bribri96/robot/README.md

# Repo che contiene il mio progetto di maturità
