bribri96/robot/Presentazione.pptx

Simulazione di un impianto industriale per la manipolazione degli oggetti
Bertolani Andrea, ITIS “E. Fermi” Modena
A.S. 2014-2015

## Slide 2

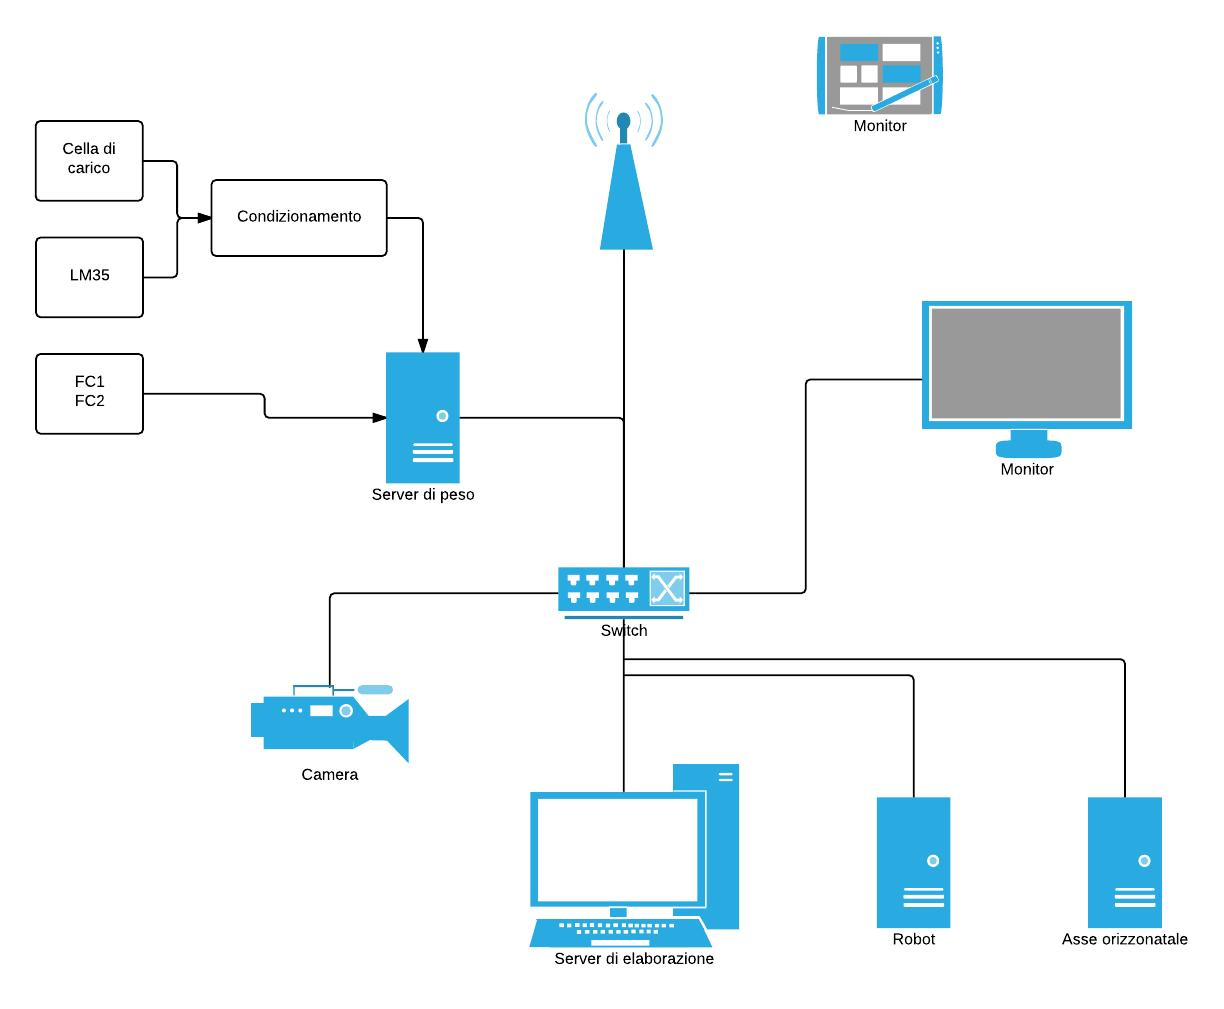
[picture p1: figure]

## Slide 3

Riconoscimento Oggetti

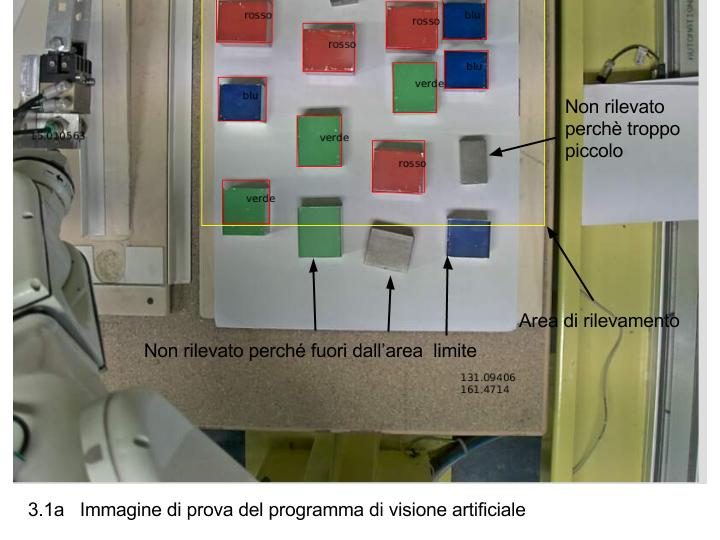
[picture p2: figure]

Parametri

Trasformazione

Trasmissione

## Slide 4

Sistema di Pesatura

- Microcontrollore
  - ADC
  - Ethernet
- Condizionamento
- Trasmissione

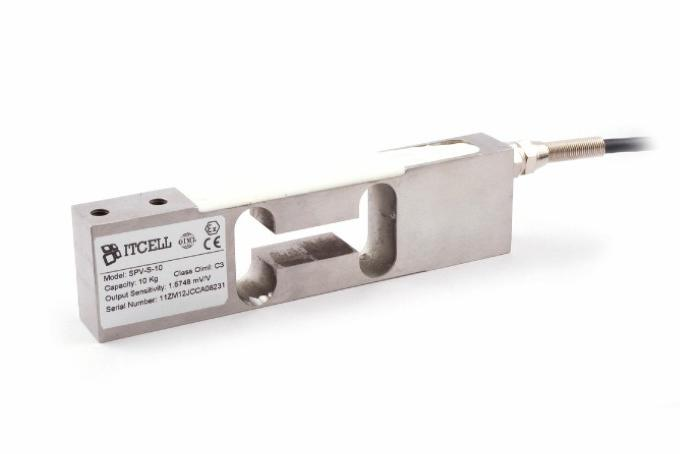
[picture p3: figure]

## Slide 5

Spostamento Oggetti

- Robot
- Ricezione dati
- Ciclo di lavoro

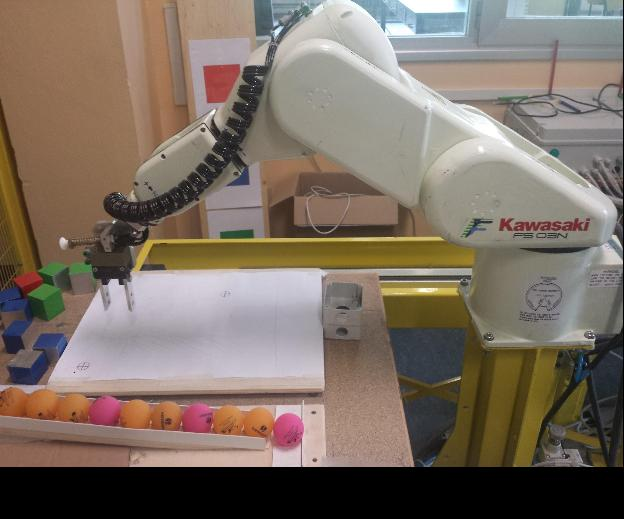
[picture p4: figure]

## Slide 6

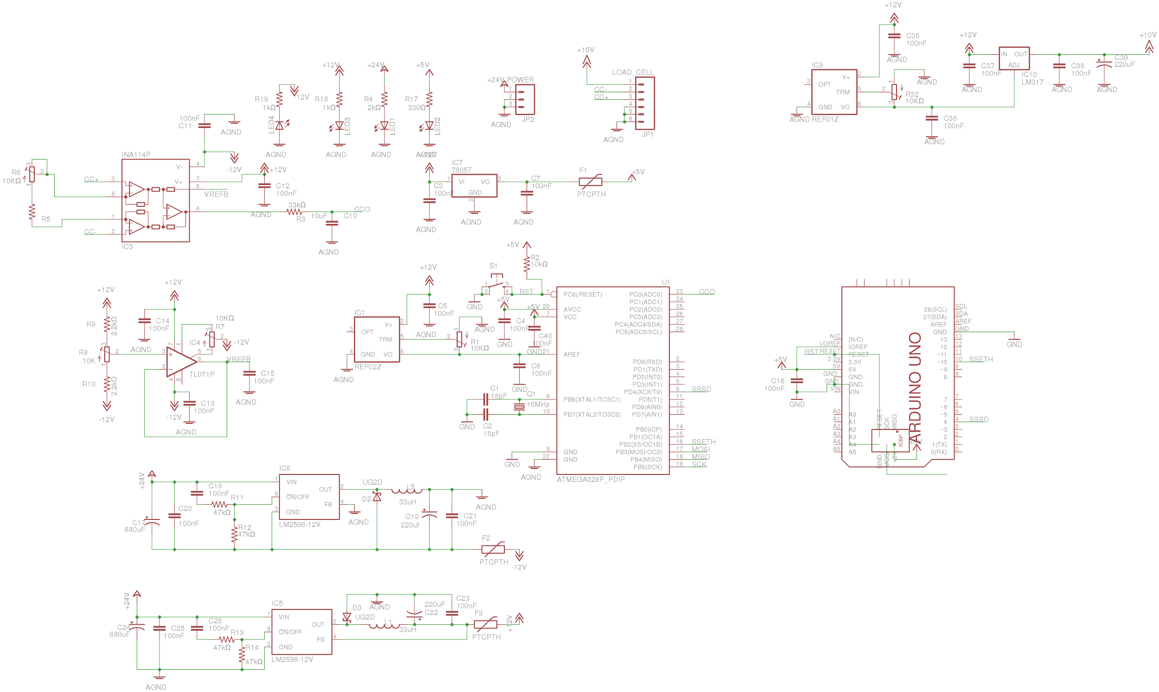
[picture p5: figure]

Schema Elettrico della Cella di Carico

## Slide 7

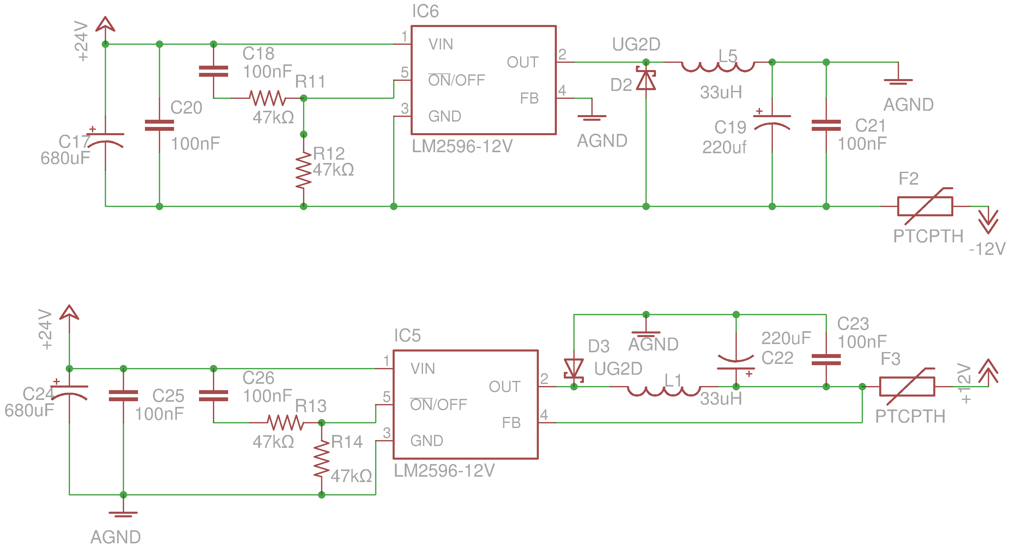
[picture p6: figure]

Power supply circuits

## Slide 8

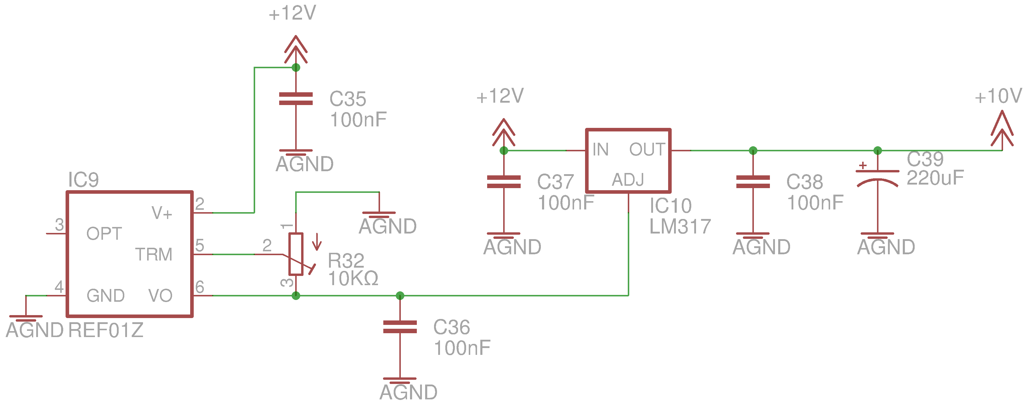
[picture p7: figure]

Load cell power supply

## Slide 9

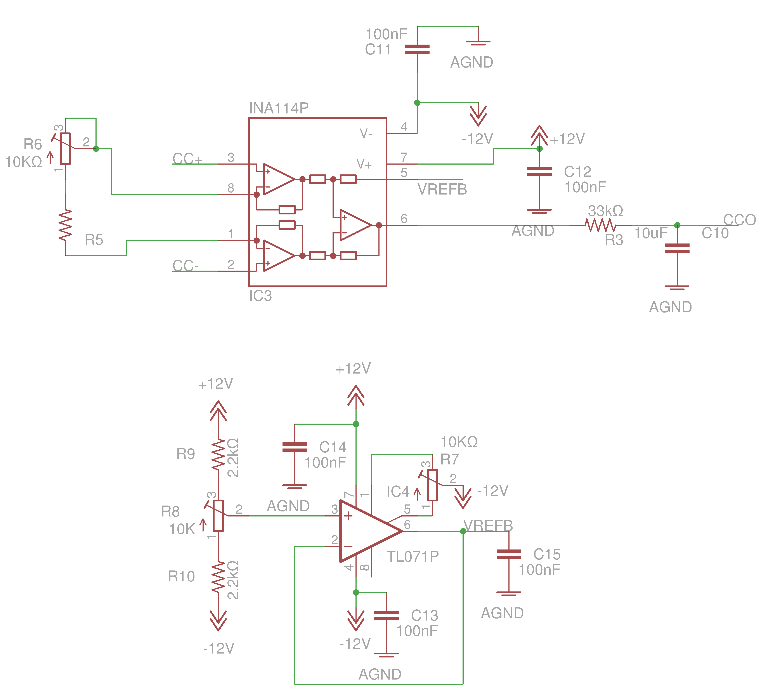
[picture p8: figure]

Amplificazione del Segnale

## Slide 10

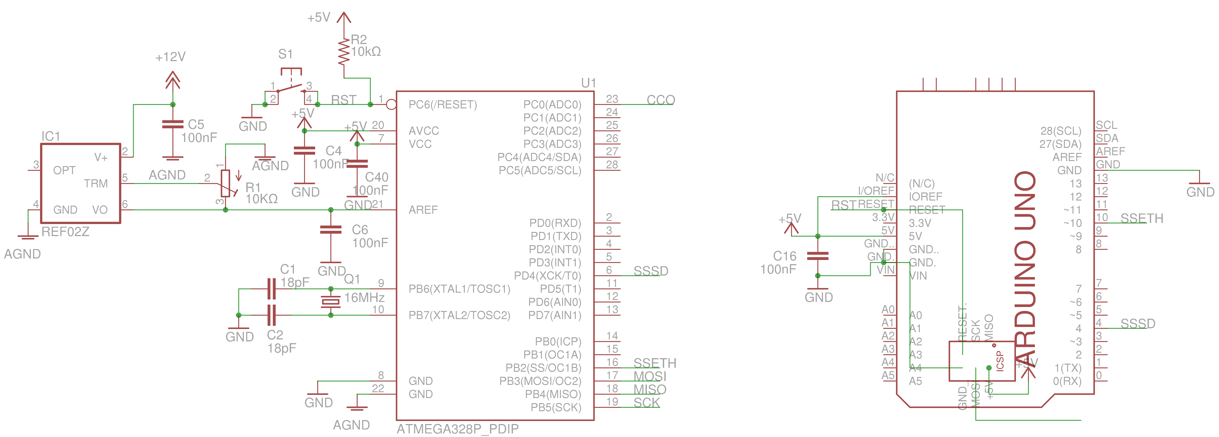
[picture p9: figure]

Microcontrollore e Scheda di Rete

## Slide 11

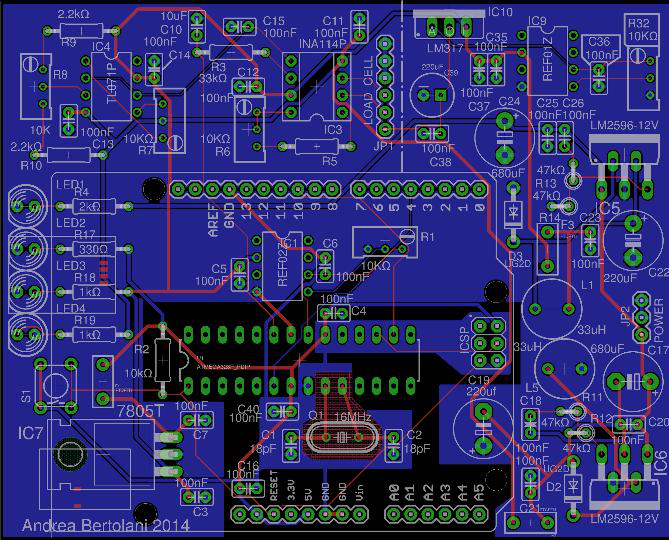
[picture p10: figure]

Circuito stampato della cella di carico

## Slide 12

## Slide 13

Grazie per l’attenzione
