bribri96/robot/schemi/delay.png

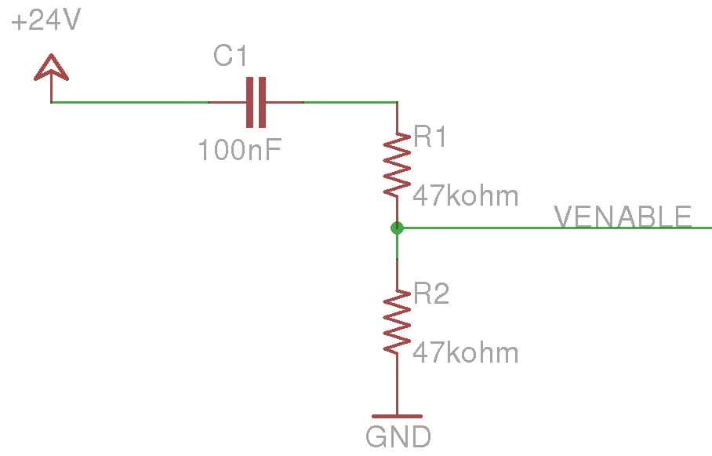
schemi/delay.png
