bribri96/robot/schemi/bilancia_smart.pdf

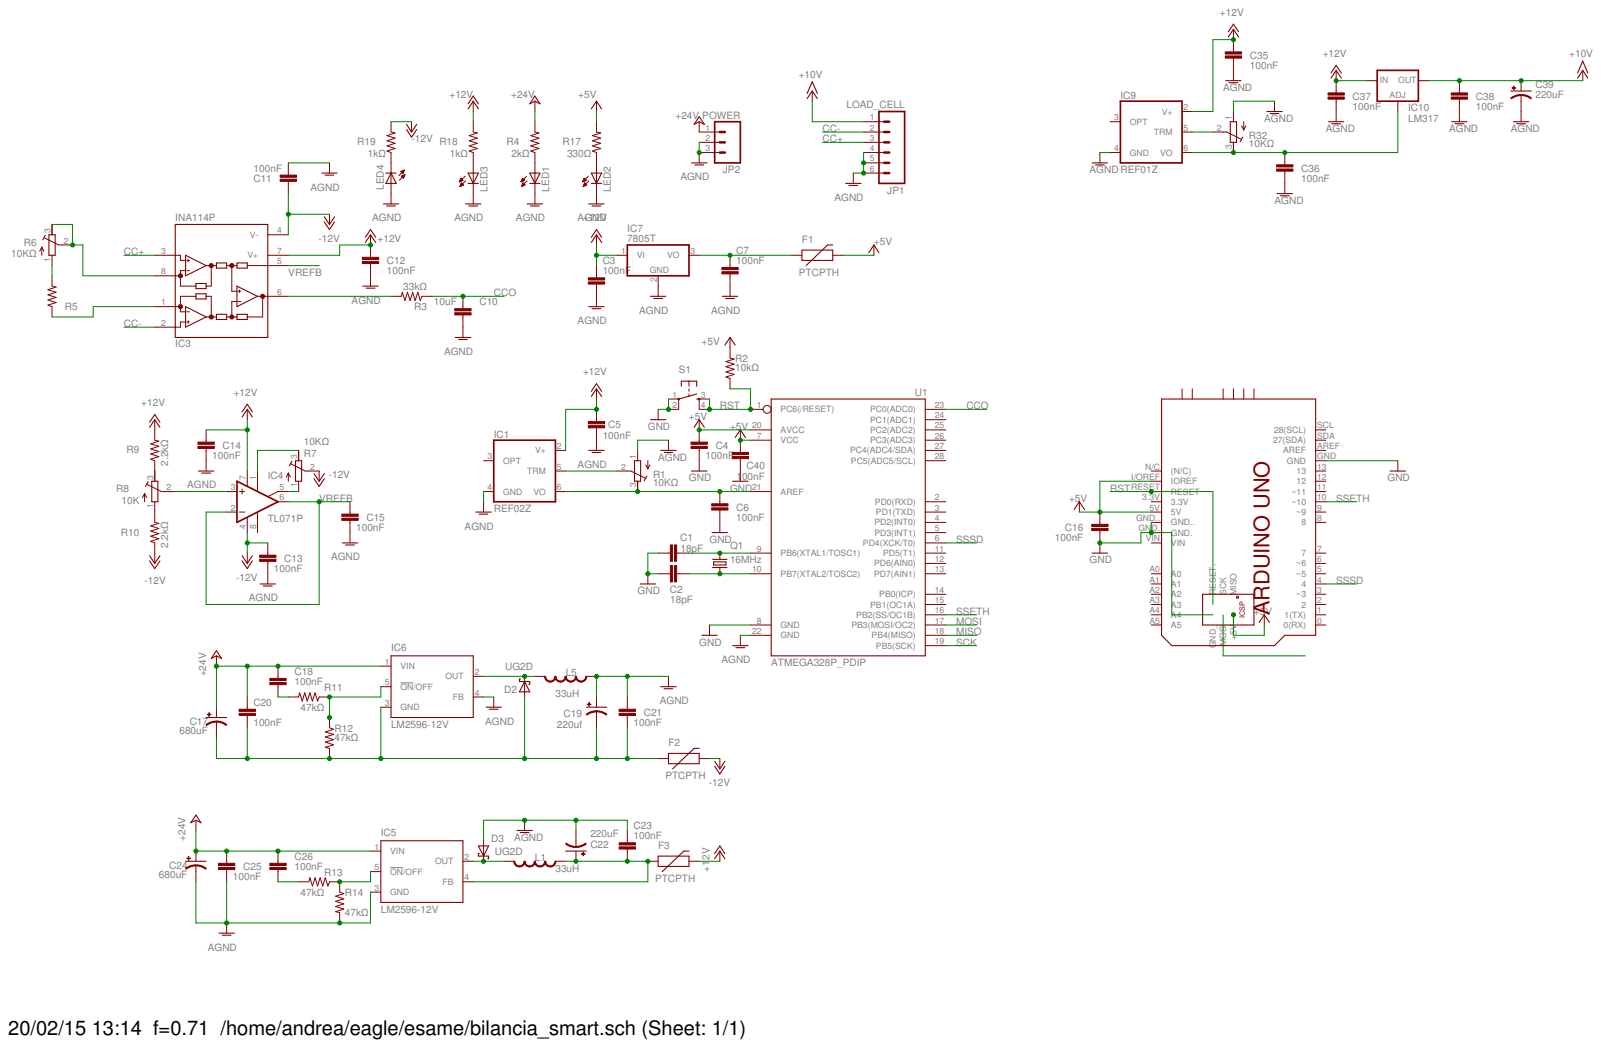
[picture p22: page 1]

+5V MOSI GND_ RESET. SCK MISO

SCK MISO MOSI SSETH

20/02/15 13:14 f=0.71 /home/andrea/eagle/esame/bilancia_smart.sch (Sheet: 1/1)
