bribri96/robot/schemi/cella_carico_sch.pdf

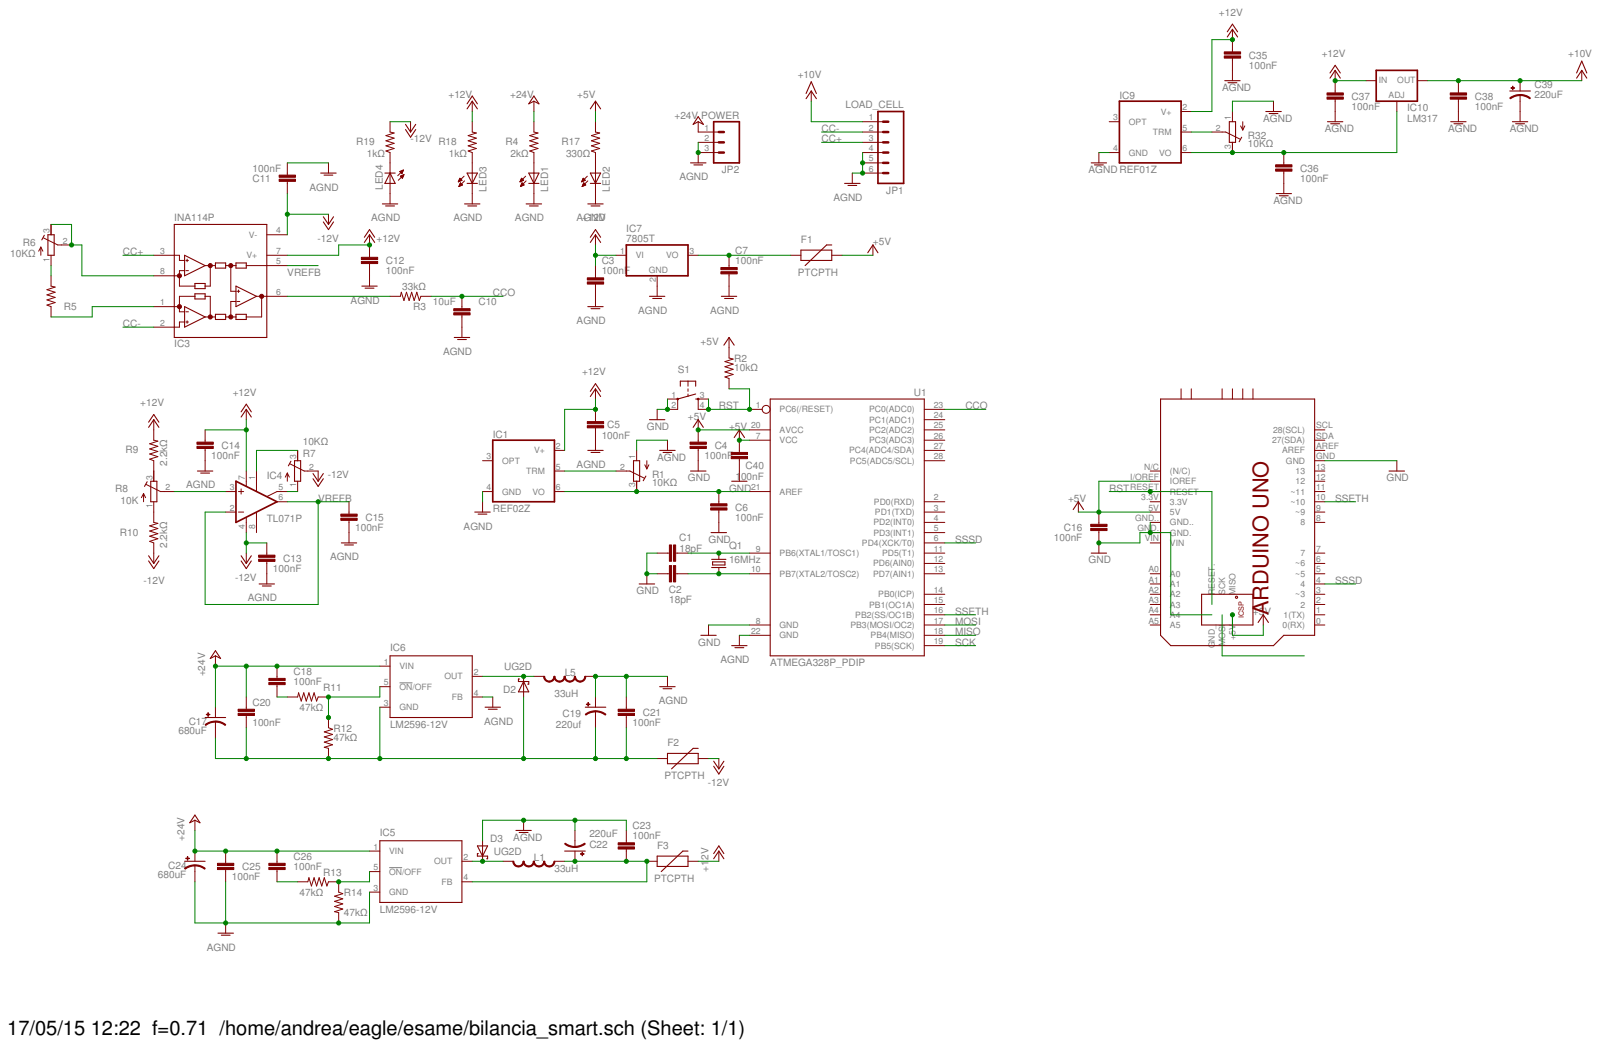
[picture p23: page 1]

+5V MOSI GND_ RESET. SCK MISO

SCK MISO MOSI SSETH

17/05/15 12:22 f=0.71 /home/andrea/eagle/esame/bilancia_smart.sch (Sheet: 1/1)
