bribri96/robot/schemi/bilancia_smart_brd.pdf

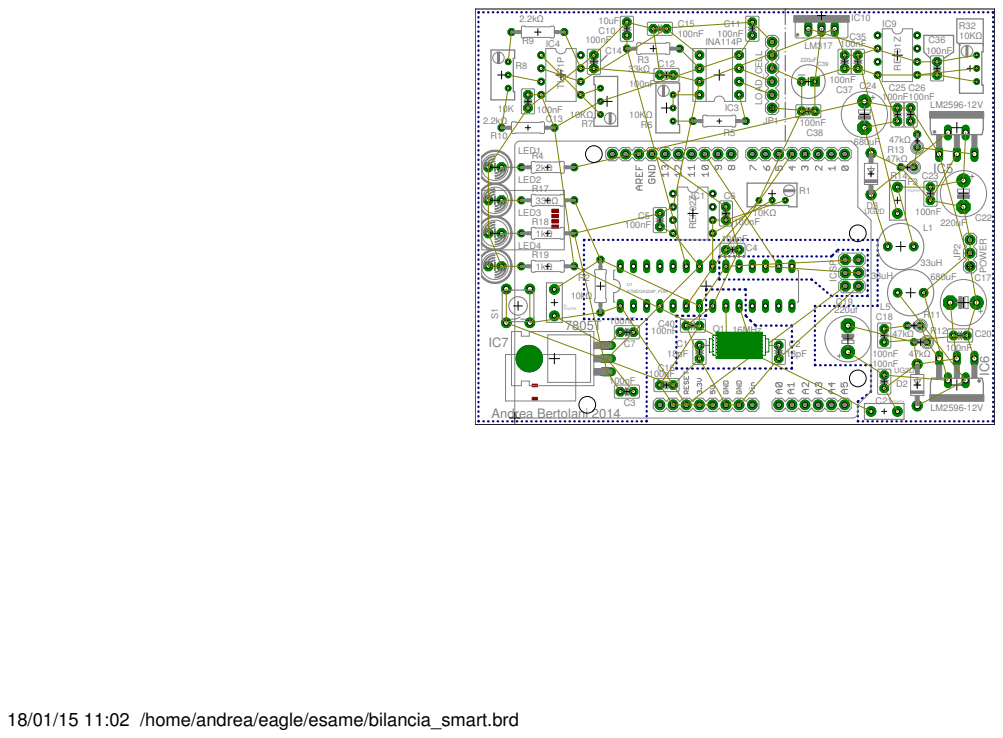
[picture p24: page 1]

18/01/15 11:02 /home/andrea/eagle/esame/bilancia_smart.brd
