bribri96/robot/schemi/cella_carico.pdf

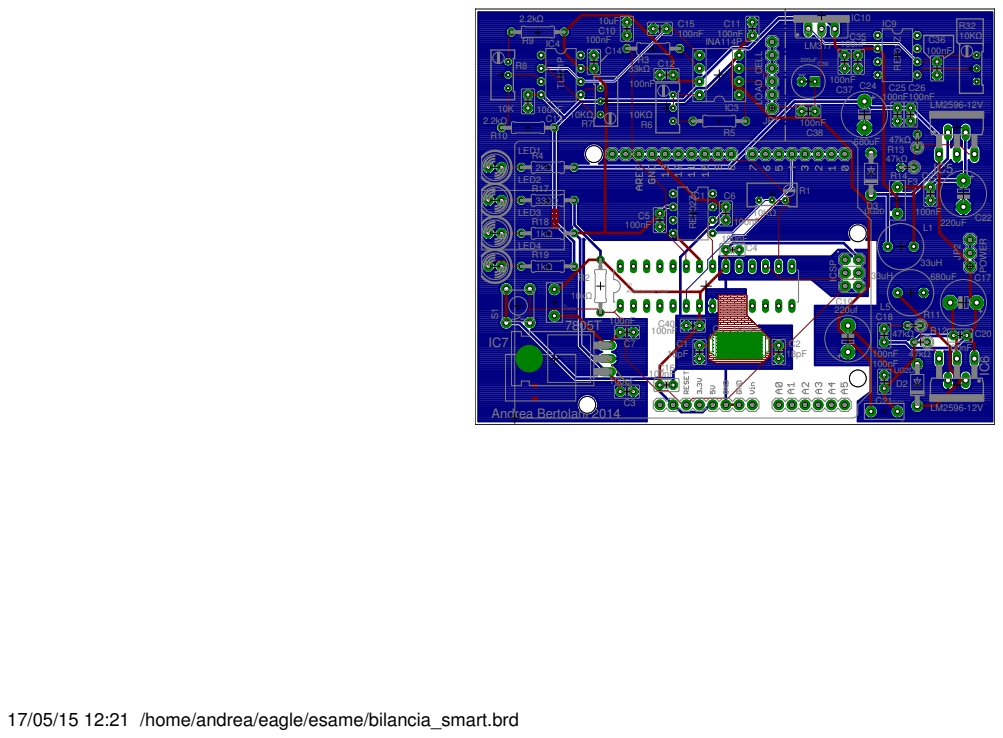
[picture p25: page 1]

17/05/15 12:21 /home/andrea/eagle/esame/bilancia_smart.brd
