bribri96/robot/schemi/cella_carico_brd.pdf

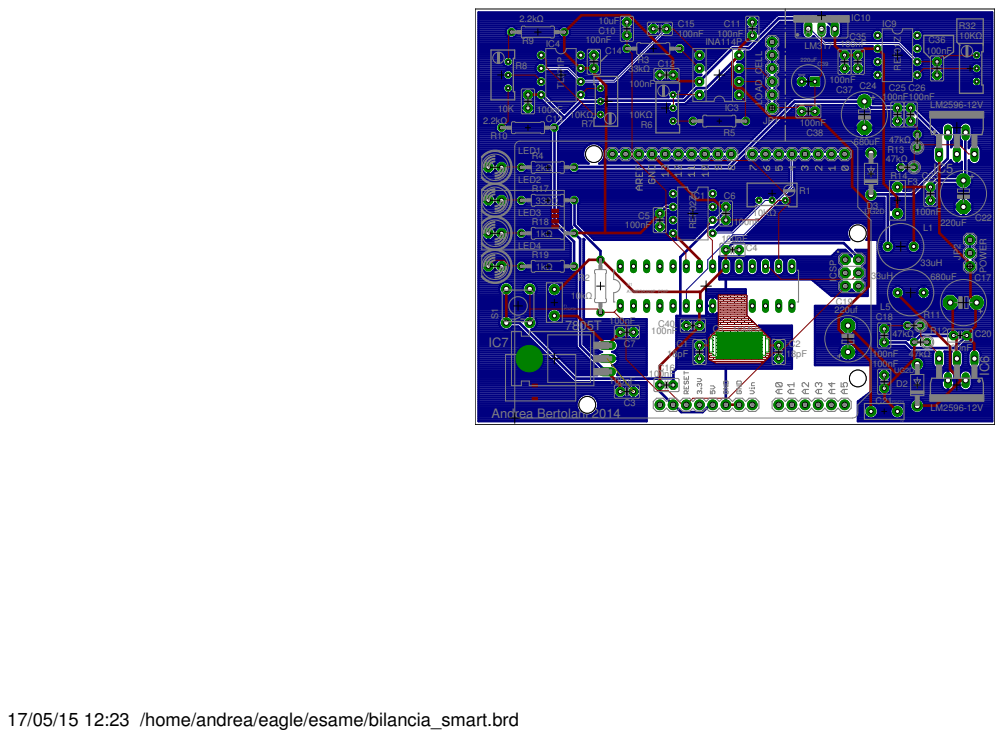
[picture p26: page 1]

17/05/15 12:23 /home/andrea/eagle/esame/bilancia_smart.brd
