bribri96/robot/schemi/bilancia_smart_no_route.brd

## EAGLE design schemi/bilancia_smart_no_route.brd (2015-07-31)

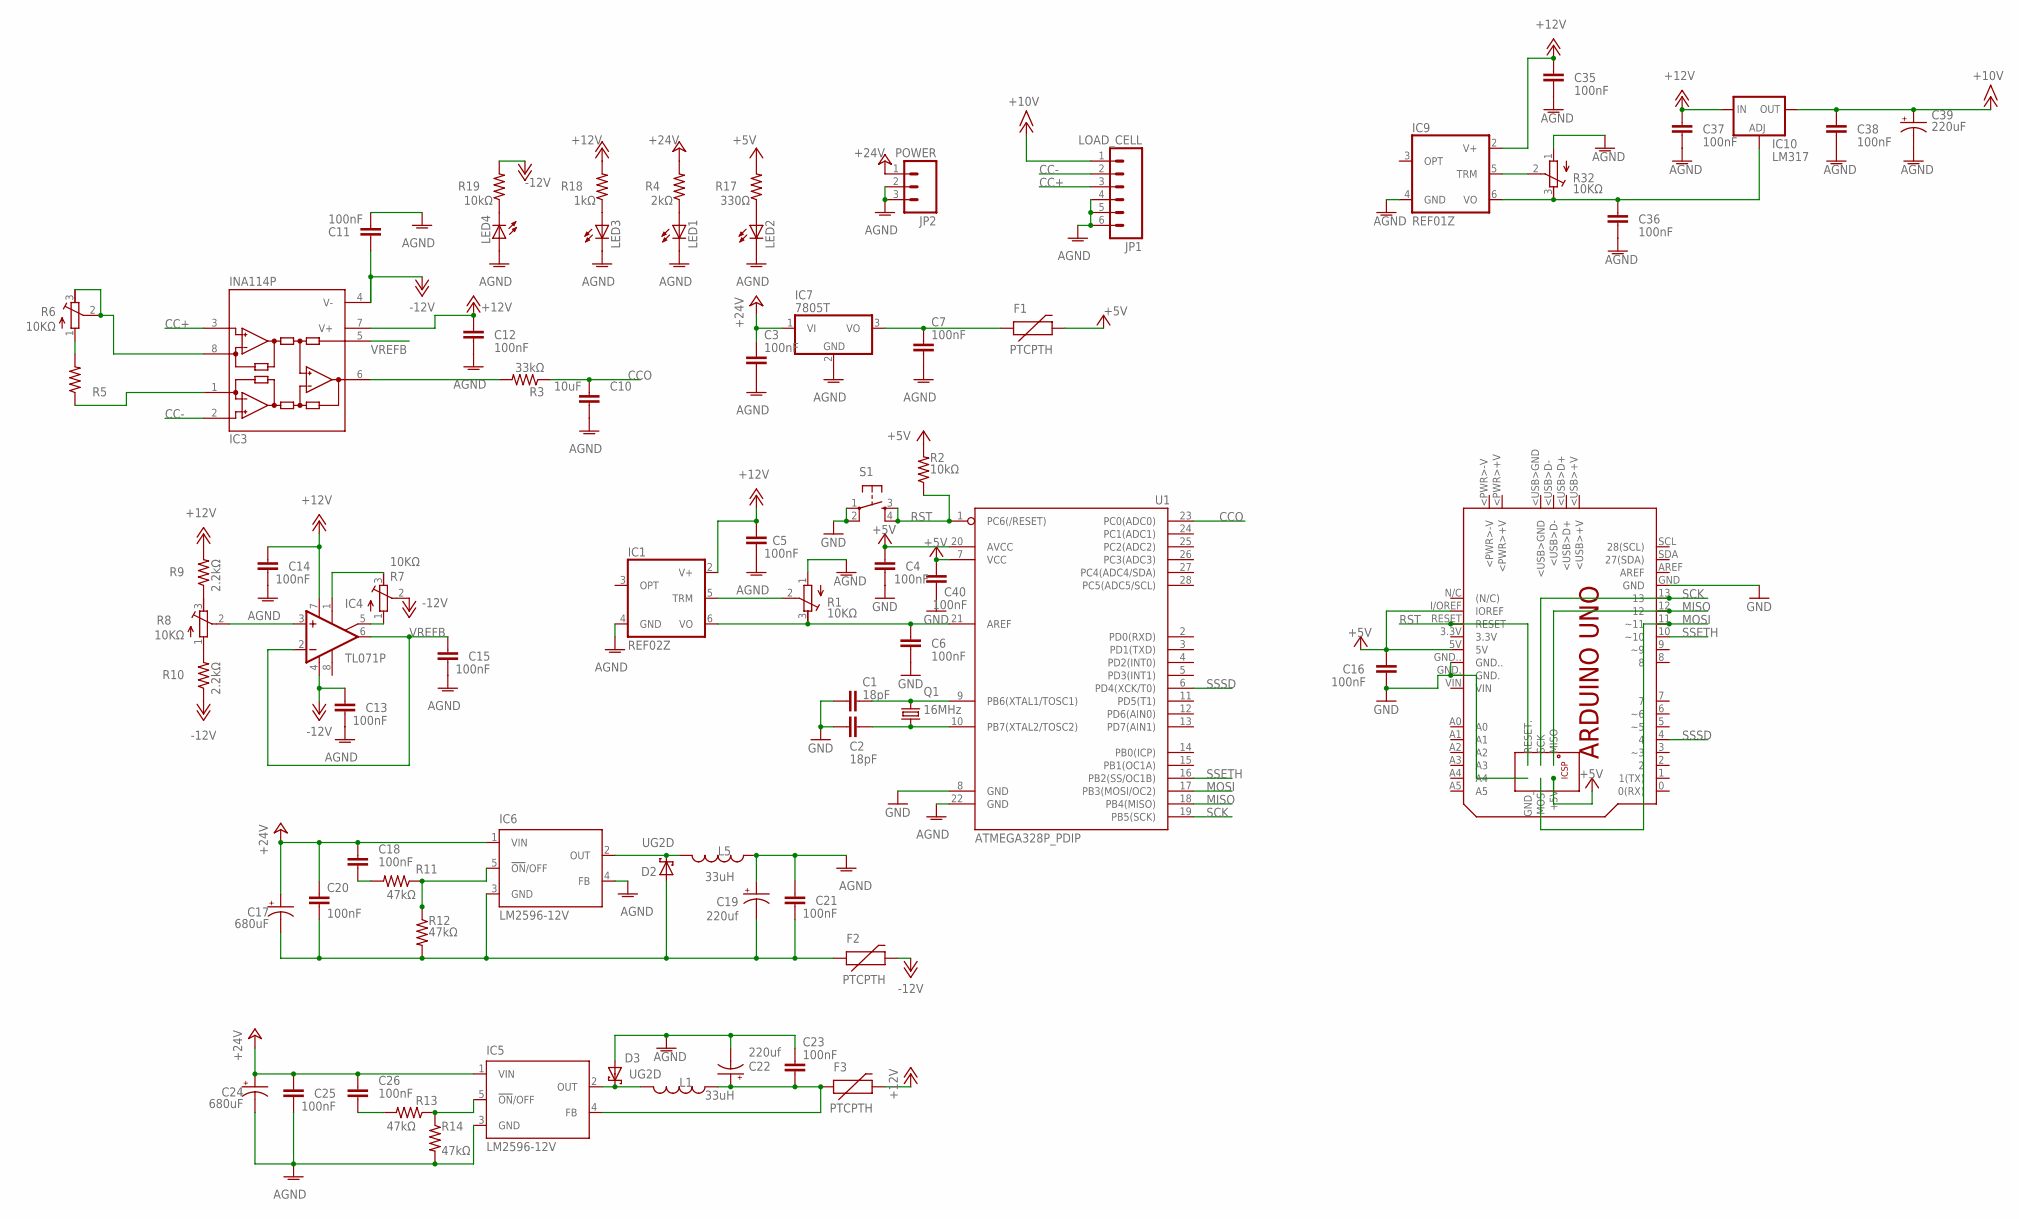
[picture p27: schematic bilancia_smart_no_route.sch]

Parts:
C1, C2: 18pF; C2.5-2
C3, C4, C5, C6, C7, C11, C12, C13, C14, C15, C16, C18, C20, C21, C23, C25, C26, C35, C36, C37, C38, C40: 100nF; C2.5-2
C10: 10uF; C2.5-2
C17, C24: 680uF; E5-8,5
C19, C22: 220uf; E5-8,5
C39: 220uF; CPOL-RADIAL-100UF-25V
D2, D3: UG2D; DO41-7
F1, F2, F3: PTCPTH; PTC
IC1: REF02Z; DIL08
IC3: INA114P; DIL08
IC4: TL071P; DIL08
IC5, IC6: LM2596-12V; T05D
IC7: 7805T; TO220H
IC9: REF01Z; DIL08
IC10: LM317; 317TS
JP1: LOAD_CELL; 1X06
JP2: POWER; 1X03
L1, L5: 33uH; RLB0912
LED1, LED2, LED3, LED4: MINIMIDI_LED5MM
PCB1: ARDUINO_UNO
Q1: 16MHz; HC49/S
R1, R6, R7, R8, R32: 10KΩ; RTRIM64W
R2, R19: 10kΩ; 0207/10
R3: 33kΩ; 0207/10
R4: 2kΩ; 0207/10
R5: R-US_0207/10; 0207/10
R9, R10: 2.2kΩ; 0207/10
R11, R12, R13, R14: 47kΩ; 0207/2V
R17: 330Ω; 0207/10
R18: 1kΩ; 0207/10
S1: TAC_SWITCHPTH; TACTILE-PTH
U1: ATMEGA328P_PDIP; DIL28-3

Connections:
+5V: C4.2, C16.2, C40.2, F1.P$2 (2), PCB1.5V, PCB1.+5V, PCB1.I/OREF (IOREF), R2.2, R17.2, U1.7 (VCC), U1.20 (AVCC)
+12V: C5.1, C12.2, C14.2, C35.2, C37.2, F3.P$2 (2), IC1.2 (V+), IC3.7 (V+), IC4.7 (V+), IC9.2 (V+), IC10.3 (IN), R9.2, R18.2
+15V: C38.2, C39.1 (+), IC10.2 (OUT), JP1.1
+24V: C3.2, C17.+, C18.1, C20.1, C24.+, C25.1, C26.1, IC5.1 (VIN), IC6.1 (VIN), IC7.1 (VI), JP2.1, R4.2
-12V: C11.2, C13.2, F2.P$2 (2), IC3.4 (V-), IC4.4 (V-), R7.2 (S), R10.1, R19.2
AGND: C3.1, C5.2, C7.1, C10.1, C11.1, C12.1, C13.1, C14.1, C15.1, C19.+, C21.1, C22.-, C23.2, C24.-, C25.2, C35.1, C36.1, C37.1, C38.1, C39.2 (-), D3.A, IC1.4 (GND), IC5.3 (GND), IC6.4 (FB), IC7.2 (GND), IC9.4 (GND), JP1.4, JP1.5, JP1.6, JP2.2, JP2.3, L5.1, LED1.K (C), LED2.K (C), LED3.K (C), LED4.A, R1.1 (E), R14.2, R32.1 (E), U1.22 (GND)
CC+: IC3.3 (+IN), JP1.3
CC-: IC3.2 (-IN), JP1.2
CCO: C10.2, R3.1, U1.23 (PC0(ADC0))
GND: C1.1, C2.1, C4.1, C6.1, C16.1, C40.1, PCB1.GND, PCB1.GND., PCB1.GND.., PCB1.GND_, S1.1, S1.2, U1.8 (GND)
MISO: PCB1.12, PCB1.MISO, U1.18 (PB4(MISO))
MOSI: PCB1.11 (~11), PCB1.MOSI, U1.17 (PB3(MOSI/OC2))
unnamed: C6.2, IC1.6 (VO), R1.3 (A), U1.21 (AREF)
unnamed: C2.2, Q1.2, U1.10 (PB7(XTAL2/TOSC2))
unnamed: C1.2, Q1.1, U1.9 (PB6(XTAL1/TOSC1))
unnamed: LED2.A, R17.1
unnamed: IC1.5 (TRM), R1.2 (S)
unnamed: C7.2, F1.P$1 (1), IC7.3 (VO)
unnamed: IC3.6 (OUT), R3.2
unnamed: LED1.A, R4.1
unnamed: R5.2, R6.1 (E)
unnamed: IC3.8 (RG), R6.2 (S), R6.3 (A)
unnamed: IC3.1 (RG), R5.1
unnamed: IC4.5 (ON2), R7.1 (E)
unnamed: IC4.1 (ON1), R7.3 (A)
unnamed: IC6.5 (!ON!/OFF), R11.1, R12.1
unnamed: R8.3 (A), R9.1
unnamed: R8.1 (E), R10.2
unnamed: IC4.3 (+IN), R8.2 (S)
unnamed: C18.2, R11.2
unnamed: D2.C, IC6.2 (OUT), L5.2
unnamed: C22.+, C23.1, F3.P$1 (1), IC5.4 (FB), L1.1
unnamed: C17.-, C19.-, C20.2, C21.2, D2.A, F2.P$1 (1), IC6.3 (GND), R12.2
unnamed: D3.C, IC5.2 (OUT), L1.2
unnamed: IC5.5 (!ON!/OFF), R13.1, R14.1
unnamed: C26.2, R13.2
unnamed: LED3.A, R18.1
unnamed: LED4.K (C), R19.1
unnamed: C36.2, IC9.6 (VO), IC10.1 (ADJ), R32.3 (A)
unnamed: IC9.5 (TRM), R32.2 (S)
RST: PCB1.RESET, PCB1.RESET., R2.1, S1.3, S1.4, U1.1 (PC6(/RESET))
SCK: PCB1.13, PCB1.SCK, U1.19 (PB5(SCK))
SSETH: PCB1.10 (~10), U1.16 (PB2(SS/OC1B))
SSSD: PCB1.4, U1.6 (PD4(XCK/T0))
VREFB: C15.2, IC3.5 (REF), IC4.2 (-IN), IC4.6 (OUT)

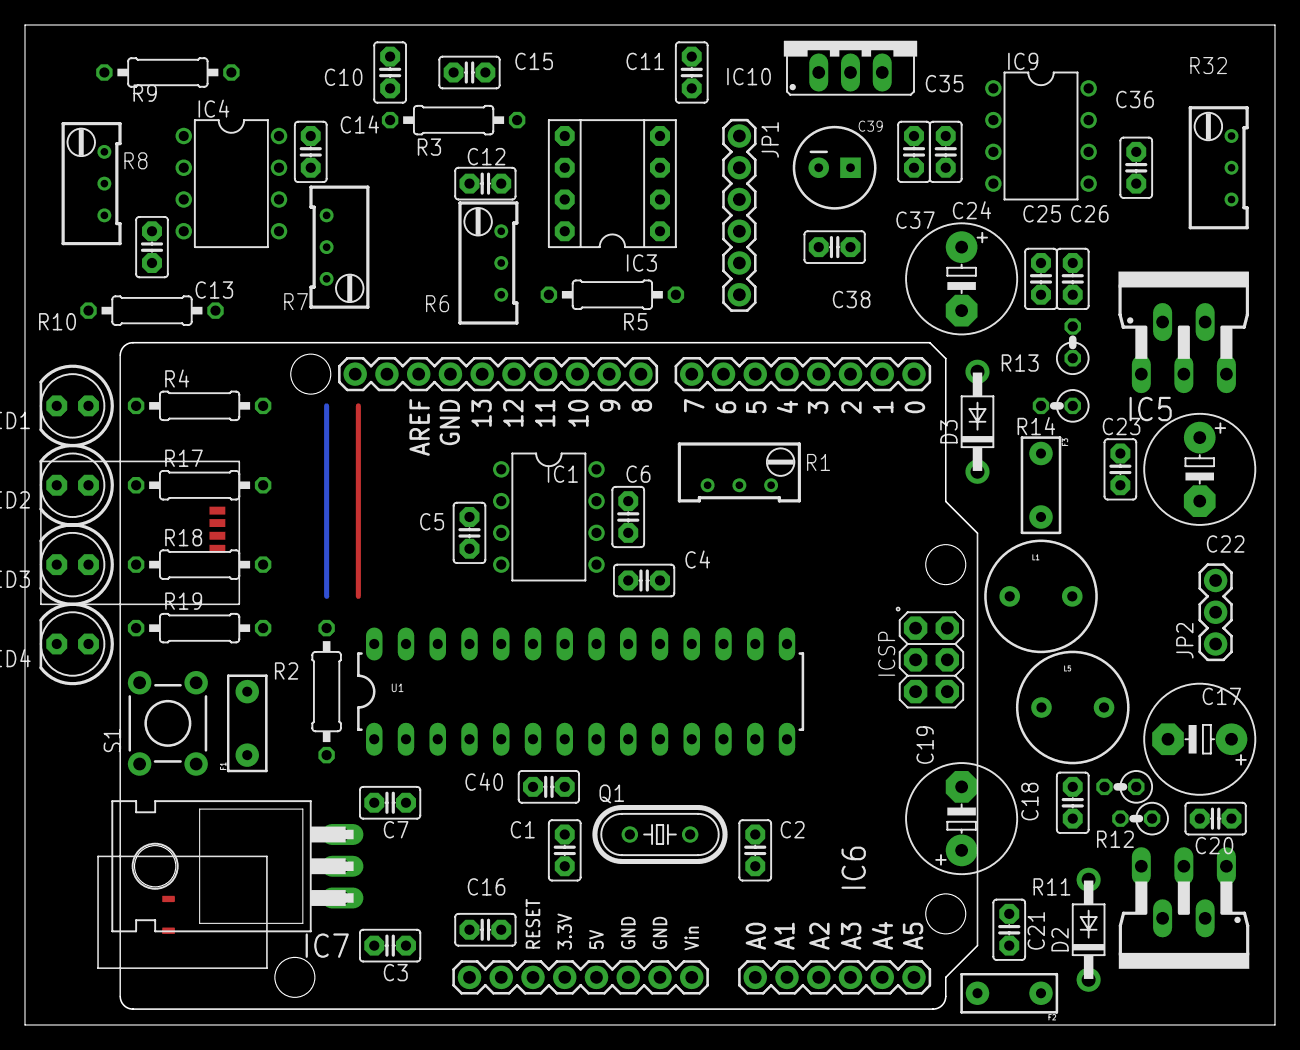
[picture p28: board bilancia_smart_no_route.brd from above]

Board: 2 copper layers, 100.0 x 80.0 mm, 73 parts (0 on the bottom side), 45 nets.
